MasteraSnackin/folding-travel-cutlery/cutlery-v9-mechanism-test.3mf

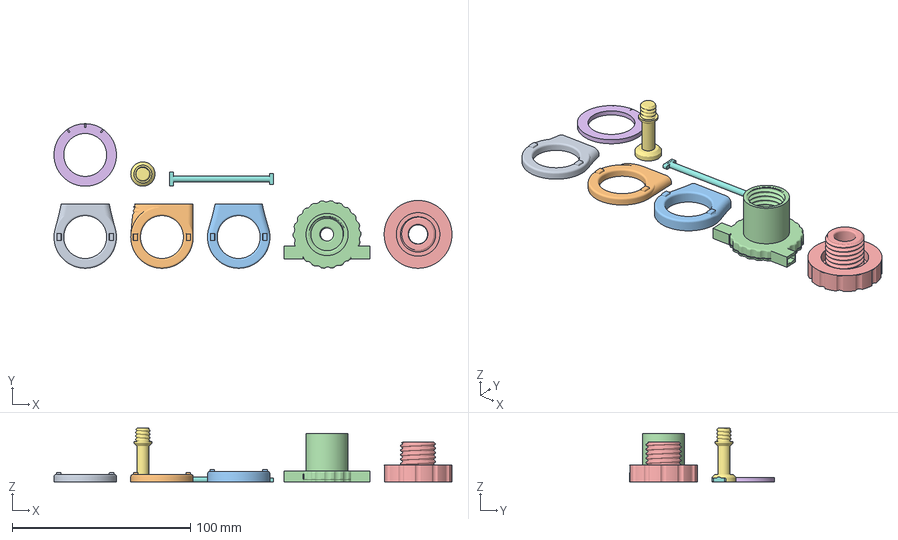
[picture p2: CAD file, 2026-10-05]
cutlery-v9-mechanism-test.3mf
223.0 x 81.0 x 30.0 mm
test_fork
test_knife
test_spoon
barrel
cap
washer
keeper
cover_key
