MasteraSnackin/folding-travel-cutlery/mechanism-test/test_knife.stl

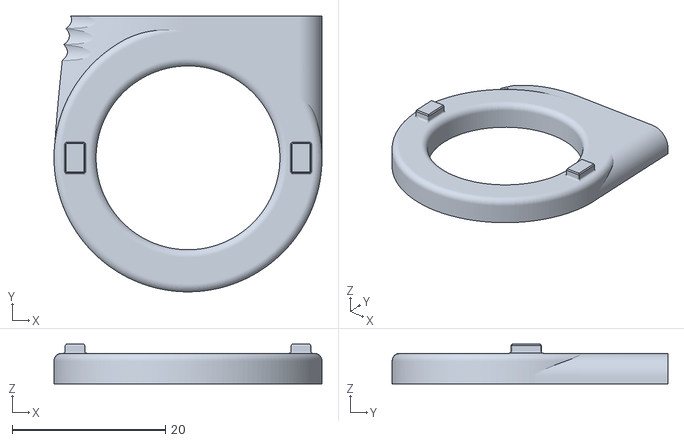
[picture p3: CAD file, 2026-10-05]
mechanism-test/test_knife.stl
35.0 x 36.0 x 5.20
