MasteraSnackin/folding-travel-cutlery/print/knife.stl

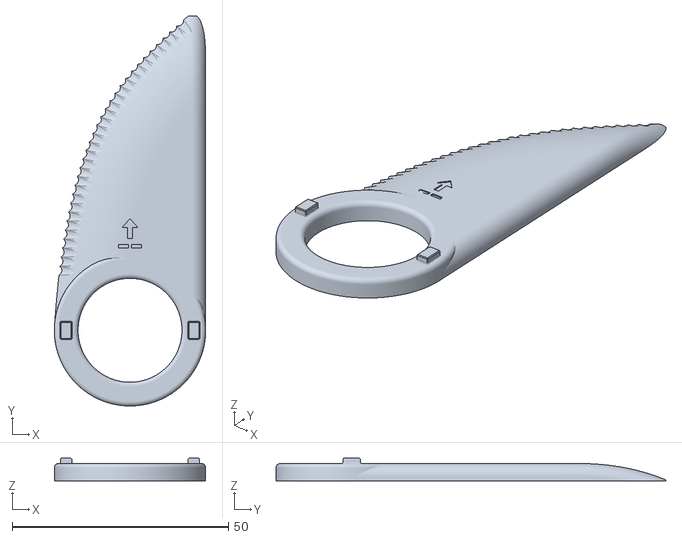
[picture p4: CAD file, 2026-10-05]
print/knife.stl
35.0 x 90.1 x 5.20
