MasteraSnackin/folding-travel-cutlery/source/pribor-cutlery-v7.3mf

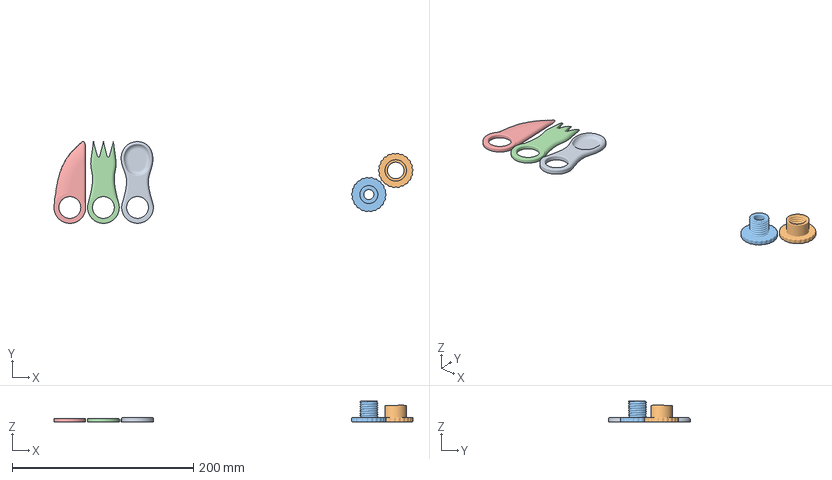
[picture p5: CAD file, 2026-10-05]
source/pribor-cutlery-v7.3mf
395.8 x 90.2 x 22.9 mm
Lžička
Matice
Šroub
Vidlička
Nůž
