MasteraSnackin/folding-travel-cutlery/cutlery-v9-folding-prototype.3mf

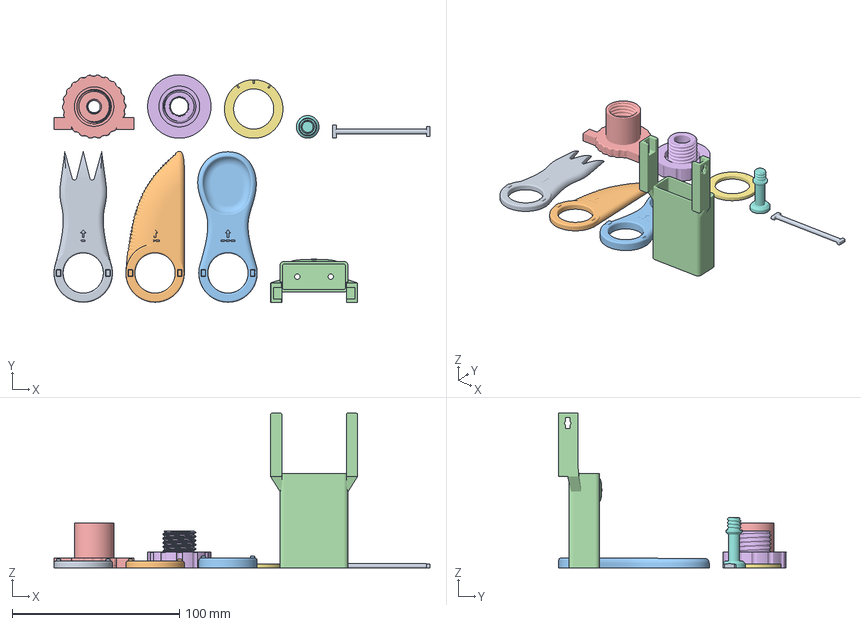
[picture p6: CAD file, 2026-10-05]
cutlery-v9-folding-prototype.3mf
225.0 x 136.1 x 92.6 mm
fork
knife
spoon
cover
barrel
cap
washer
keeper
cover_key
