MasteraSnackin/folding-travel-cutlery/mechanism-test/barrel.stl

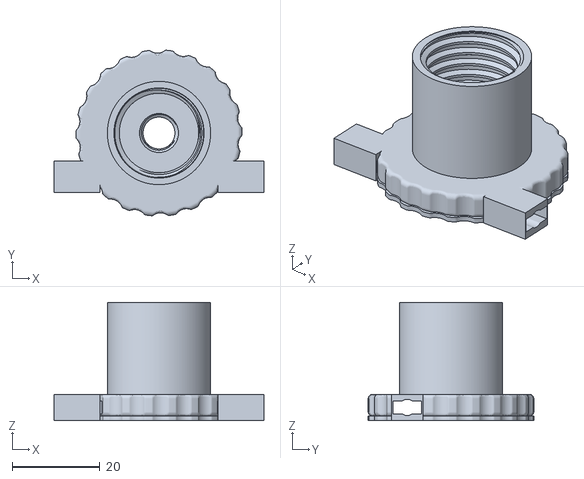
[picture p7: CAD file, 2026-10-05]
mechanism-test/barrel.stl
48.0 x 37.8 x 27.0
