MasteraSnackin/folding-travel-cutlery/print/cover_key.stl

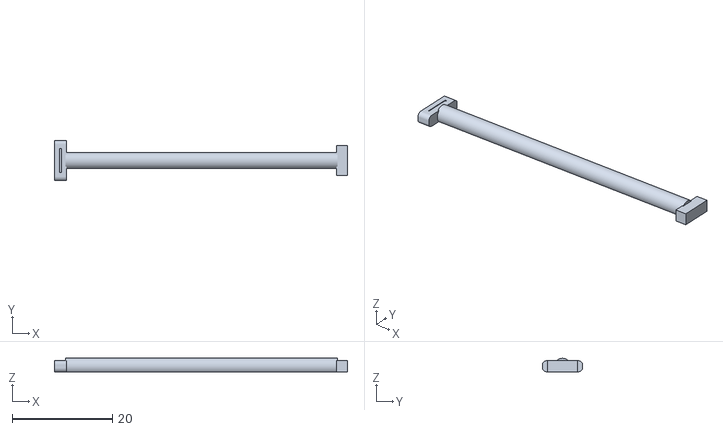
[picture p8: CAD file, 2026-10-05]
print/cover_key.stl
58.4 x 8.00 x 2.70
