MasteraSnackin/folding-travel-cutlery/mechanism-test/cap.stl

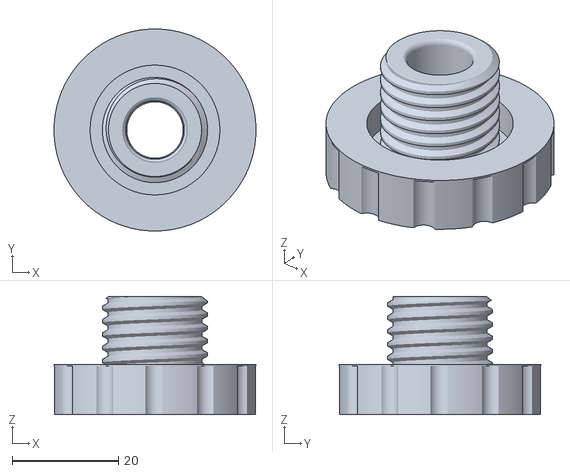
[picture p9: CAD file, 2026-10-05]
mechanism-test/cap.stl
38.0 x 38.0 x 22.2
