MasteraSnackin/folding-travel-cutlery/print/fork.stl

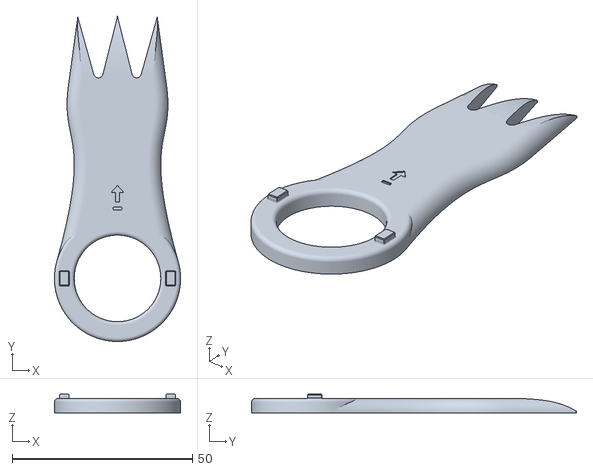
[picture p10: CAD file, 2026-10-05]
print/fork.stl
35.0 x 90.1 x 5.20
