MasteraSnackin/folding-travel-cutlery/mechanism-test/keeper.stl

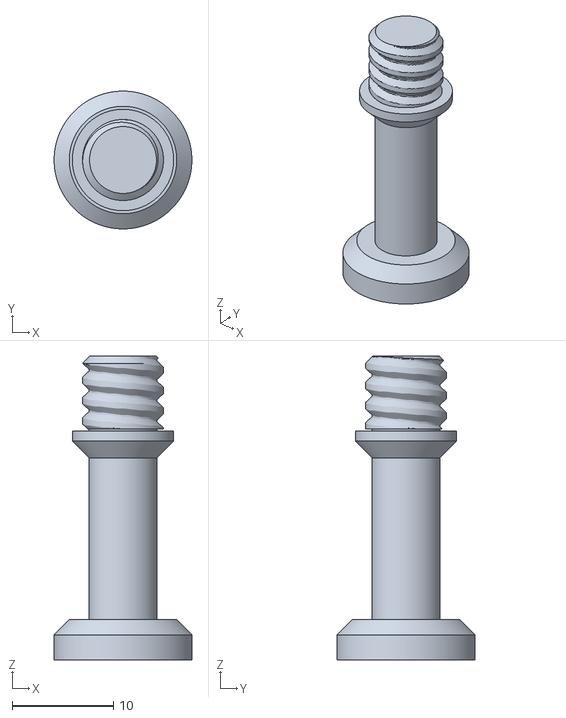
[picture p11: CAD file, 2026-10-05]
mechanism-test/keeper.stl
13.6 x 13.6 x 30.0
