MasteraSnackin/folding-travel-cutlery/print/spoon.stl

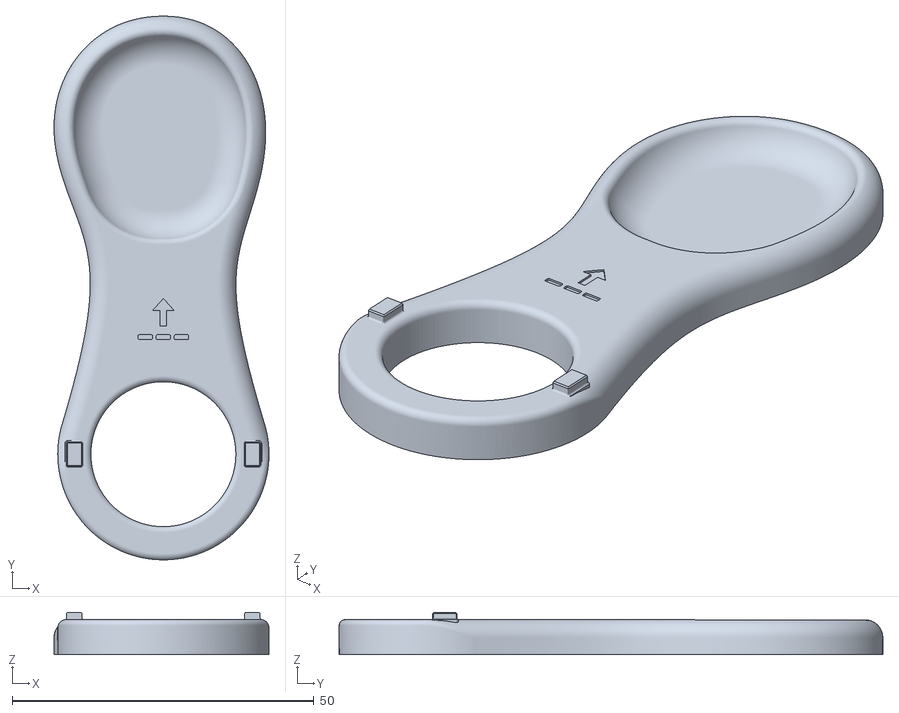
[picture p12: CAD file, 2026-10-05]
print/spoon.stl
35.6 x 90.1 x 7.00
