MasteraSnackin/folding-travel-cutlery/print/cover.stl

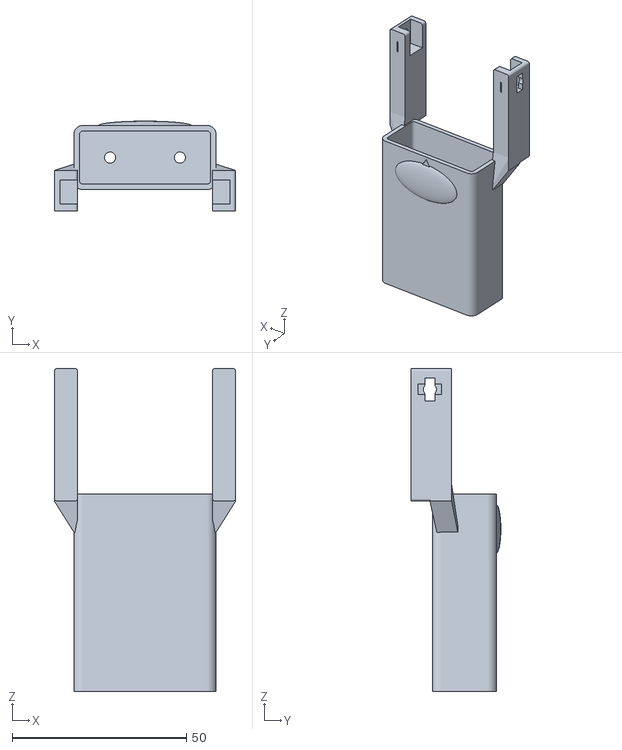
[picture p14: CAD file, 2026-10-05]
print/cover.stl
52.0 x 25.8 x 92.6
