MasteraSnackin/folding-travel-cutlery/mechanism-test/test_spoon.stl

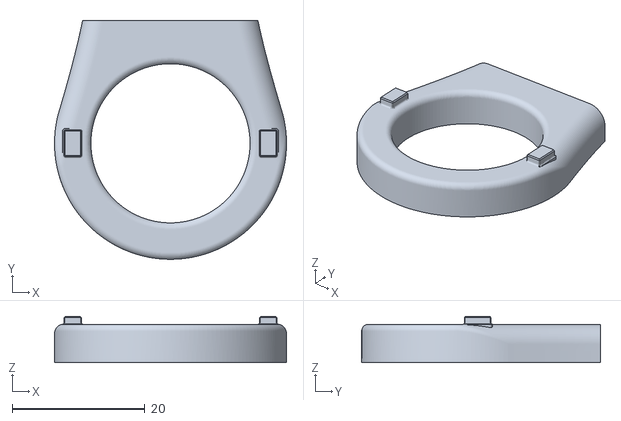
[picture p15: CAD file, 2026-10-05]
mechanism-test/test_spoon.stl
35.0 x 36.0 x 7.00
