MasteraSnackin/folding-travel-cutlery/(list of files, cad)

Other CAD files:
mechanism-test/washer.stl
print/washer.stl
